bootchk/eInkBreakout/eInkBreakout_bom_.html

Source File | /home/bootch/Dropbox/solarmobile/PCBoards/eInkBreakout/eInkBreakout/eInkBreakout.sch
BoM Date | Sat 02 Apr 2022 03:24:29 PM EDT
Schematic Version
Schematic Date
PCB Variant | default
KiCad Version | Eeschema 5.1.7-a382d34a8~88~ubuntu16.04.1
Component Groups | 2
Component Count (per PCB) | 2
Fitted Components (per PCB) | 2
Number of PCBs | 1
Total Component Count (for 1 PCBs) | 2
 | Description | Part | References | Value | Footprint | Quantity Per PCB | Datasheet | SourcePartNo
1 | Generic connector, single row, 01x07, script generated (kicad-library-utils/schlib/autogen/connector/) | Conn_01x07 | J1 | Conn_01x07 | PinHeader_1x07_P2.54mm_Vertical | 1 | ~
2 | Generic connector, single row, 01x16, script generated (kicad-library-utils/schlib/autogen/connector/) | Conn_01x16 | J2 | Conn_01x16 | TE_1-1734839-6_1x16-1MP_P0.5mm_Horizontal | 1 | ~ | 1-1734592-6
