bootchk/eInkBreakout/eInkBreakout.sch

## KiCad design eInkBreakout.sch (2022-04-02)

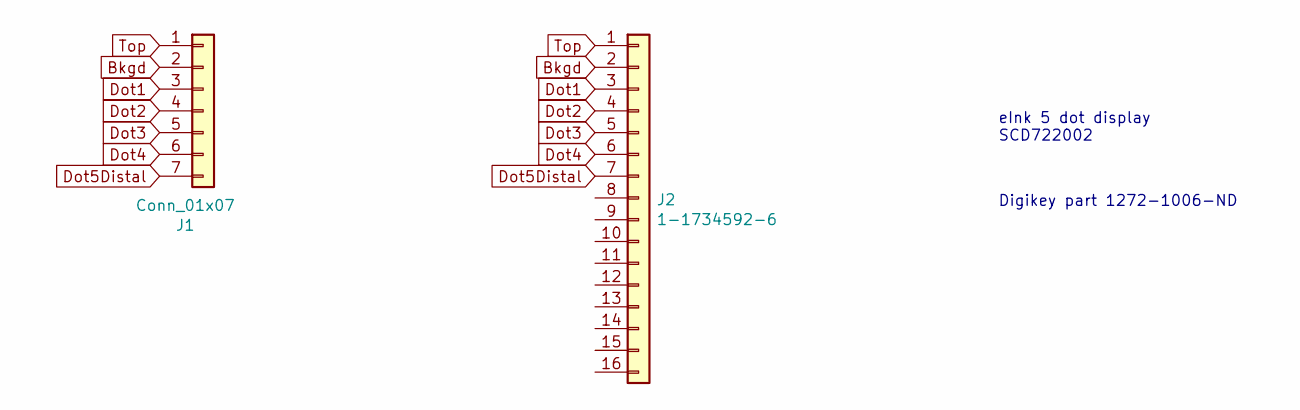
[picture p1: schematic eInkBreakout.sch]

Parts:
J1: Conn_01x07; PinHeader_1x07_P2.54mm_Vertical
J2: 1-1734592-6; TE_1-1734839-6_1x16-1MP_P0.5mm_Horizontal

Connections:
Bkgd: J1.2, J2.2
Dot1: J1.3, J2.3
Dot2: J1.4, J2.4
Dot3: J1.5, J2.5
Dot4: J1.6, J2.6
Dot5Distal: J1.7, J2.7
Top: J1.1, J2.1

Notes on the sheet:
eInk 5 dot display SCD722002
Digikey part 1272-1006-ND
